Picatout/bp-chipcon/schip-mode.png

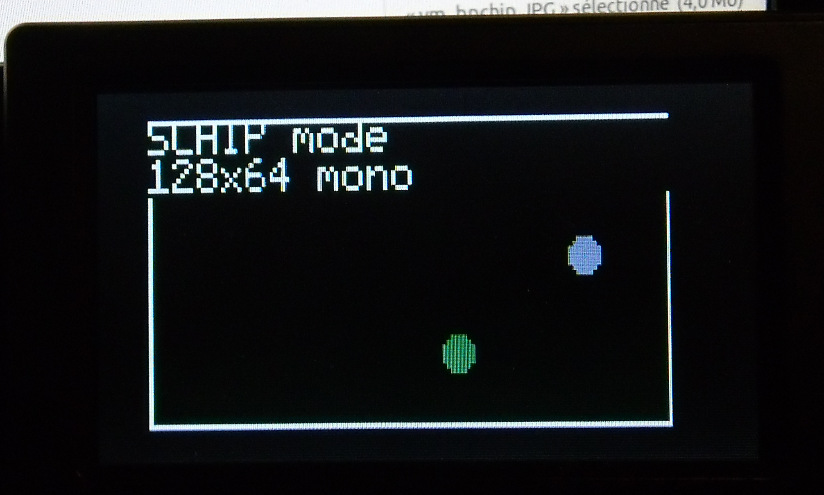
schip-mode.png
