Picatout/bp-chipcon/vm_bpchip.JPG

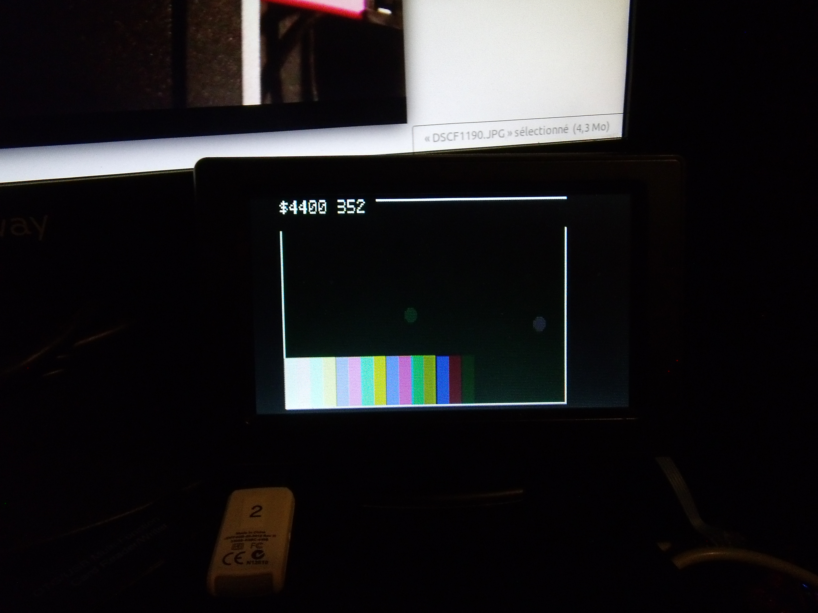
vm_bpchip.JPG
