Picatout/bp-chipcon/vmode-bp-chip.jpg

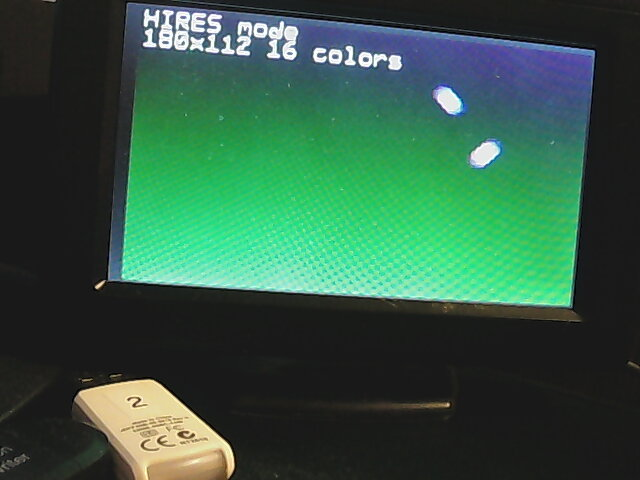
vmode-bp-chip.jpg
