Picatout/bp-chipcon/bp-chipcon-schematic.pdf

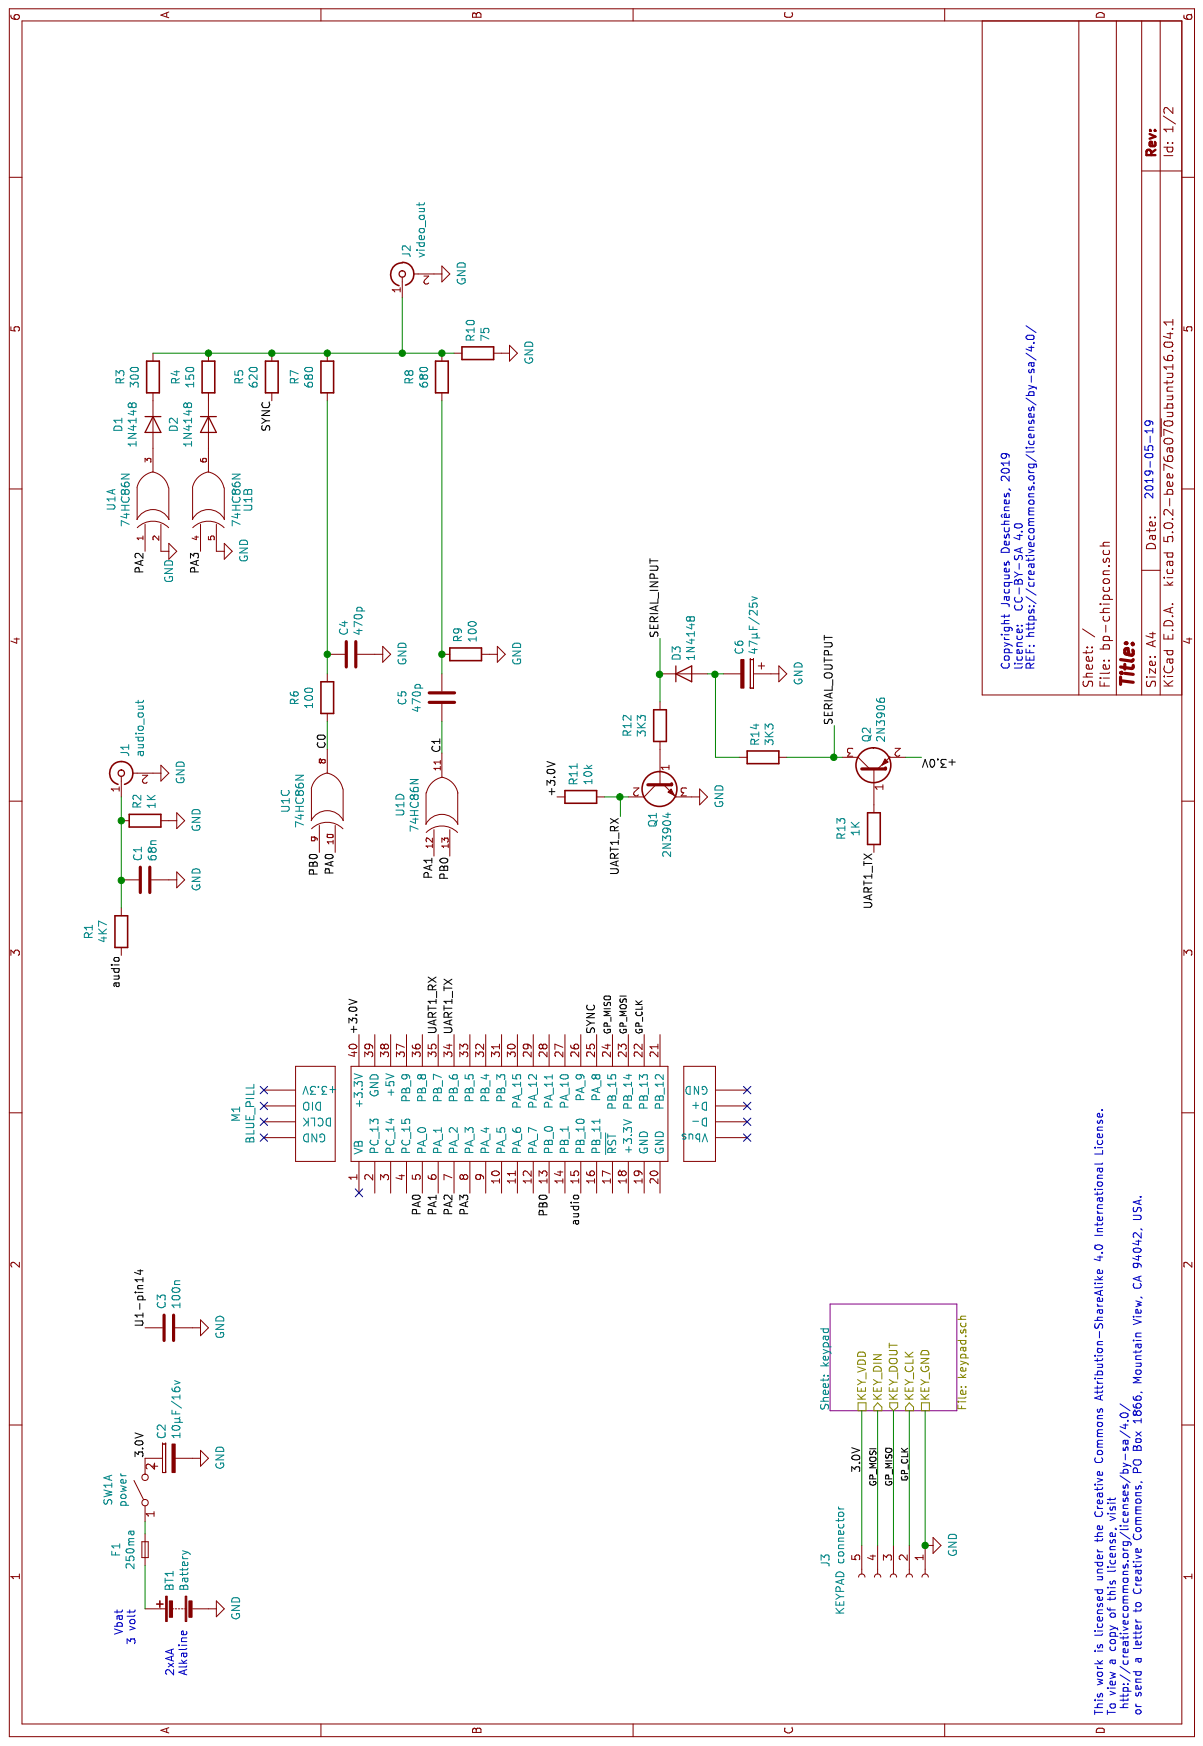
[picture p18: page 1]

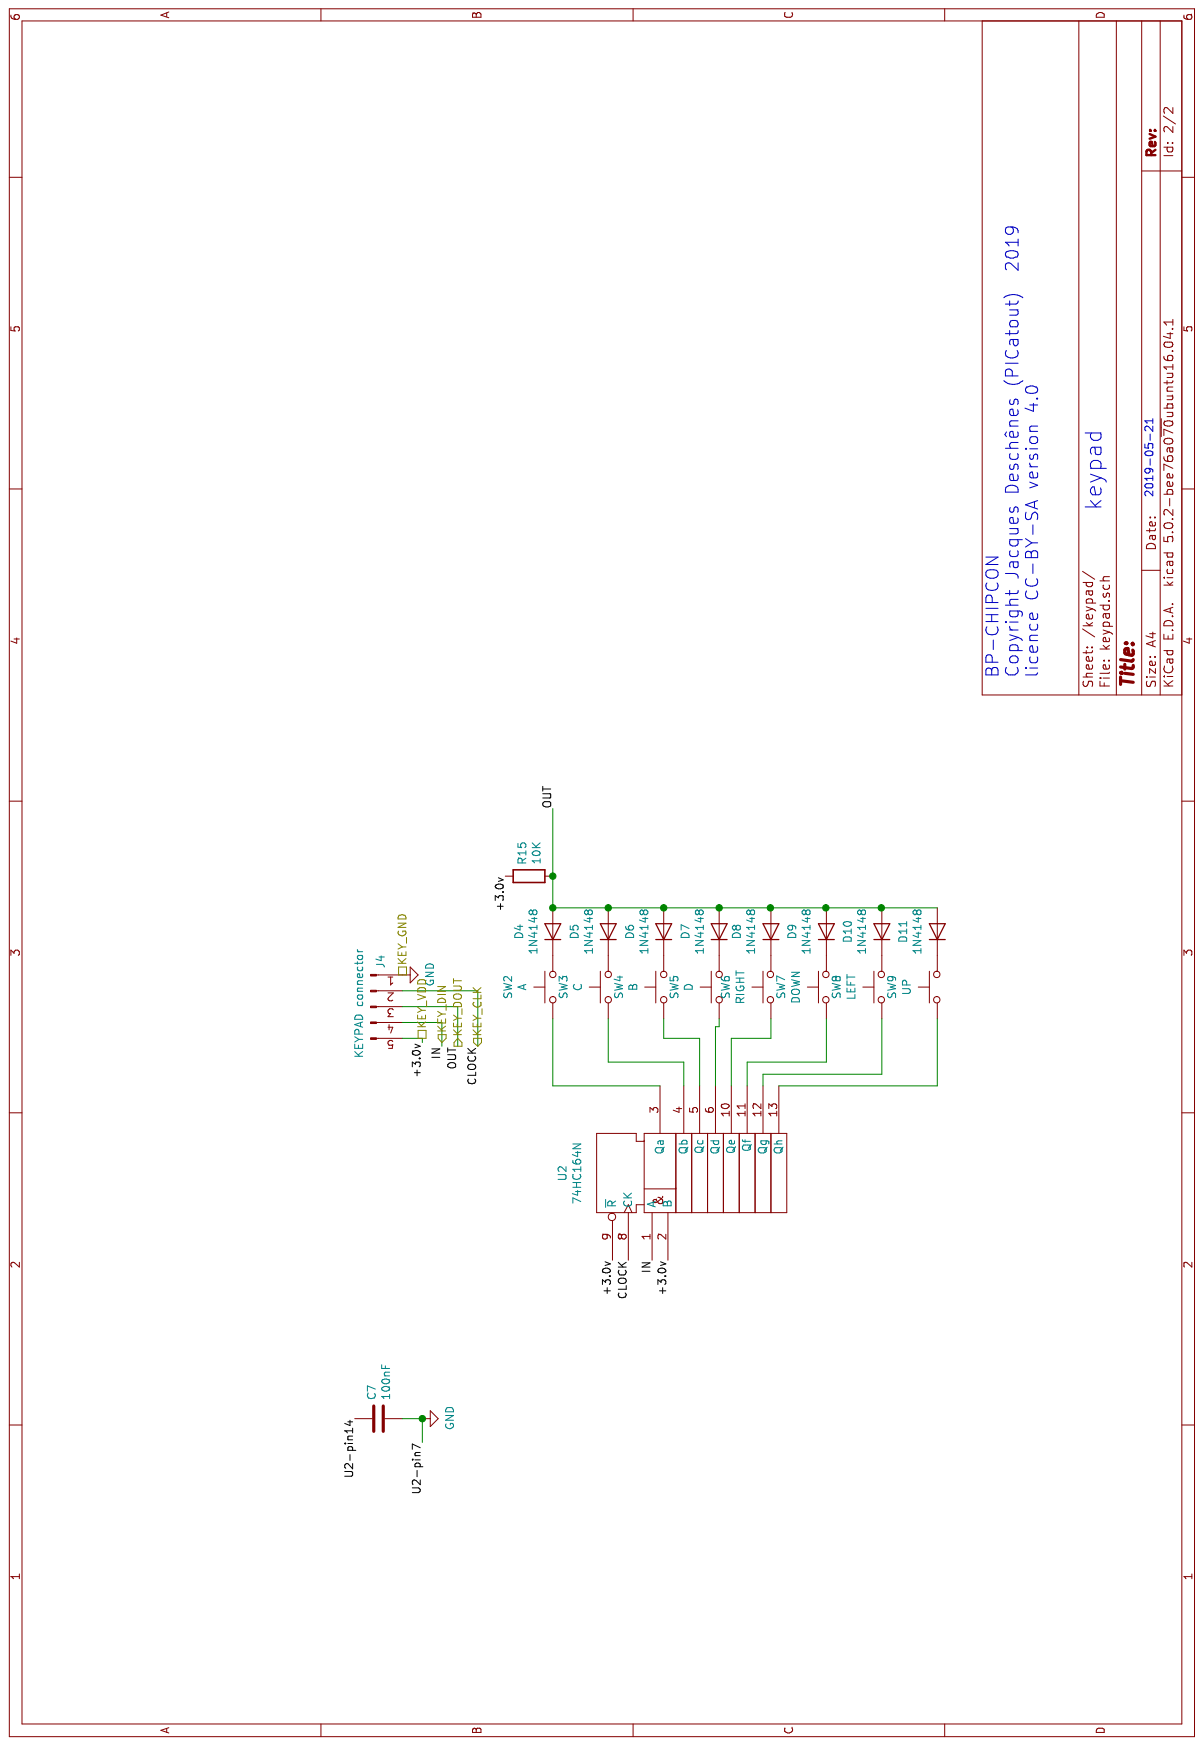
[picture p19: page 2]
