Picatout/bp-chipcon/KiCAD/bp-chipcon/bp-chipcon.kicad_pcb

## KiCad design Reflectance_Sensor/Reflectance_Sensor.sch

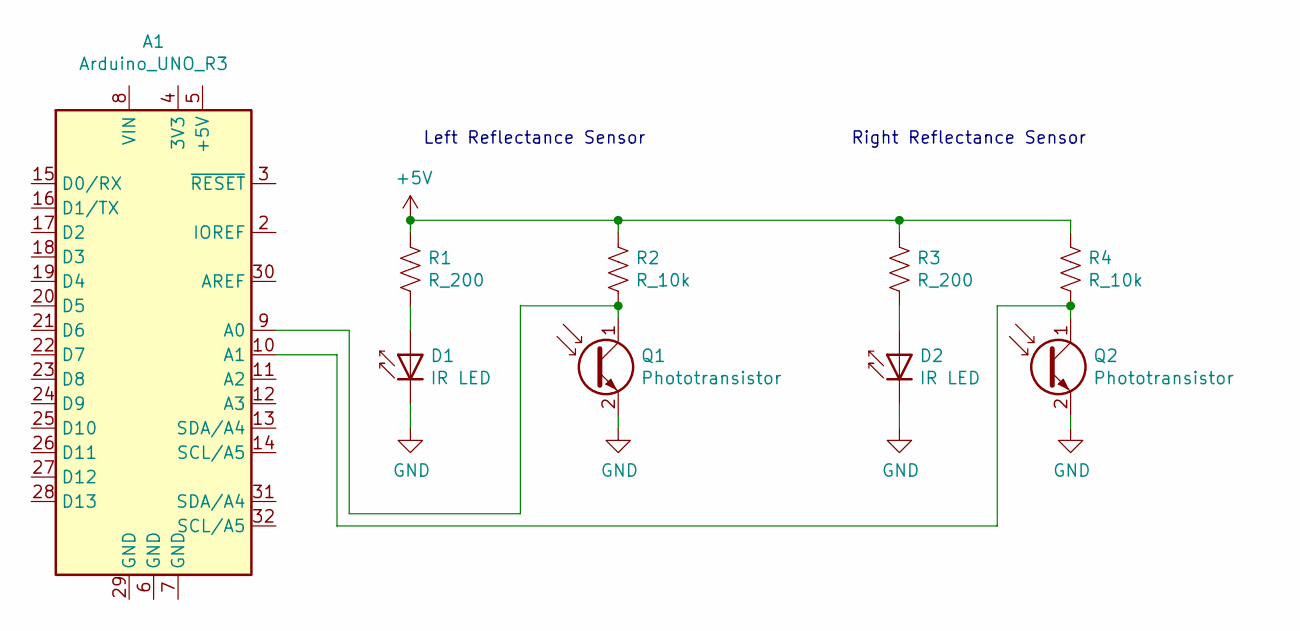
[picture p20: schematic Reflectance_Sensor.sch]

Parts:
A1: Arduino_UNO_R3
D1, D2: IR LED; LED_D3.0mm_IRBlack
Q1, Q2: Phototransistor
R1, R3: R_200
R2, R4: R_10k

Connections:
+5V: R1.1, R2.1, R3.1, R4.1
GND: D1.1 (K), D2.1 (K), Q1.2 (E), Q2.2 (E)
unnamed: A1.9 (A0), Q1.1 (C), R2.2
unnamed: A1.10 (A1), Q2.1 (C), R4.2
unnamed: D1.2 (A), R1.2
unnamed: D2.2 (A), R3.2

Notes on the sheet:
Left Reflectance Sensor
Right Reflectance Sensor
