Picatout/bp-chipcon/graphics.c

/*
* Copyright Jacques Deschênes 2018, 2019 
* This file is part of BP_CHIPCON.
*
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
*     You should have received a copy of the GNU General Public License
*     along with BP_CHIPCON.  If not, see <http://www.gnu.org/licenses/>.
*/

/*
 * Description: SUPER CHIPCON game console on BLUE PILL.
 * 
 * Auteur: PICATOUT
 * Date: 2019-05-01
 * Copyright Jacques Deschênes, 2019
 * Licence: GPLv3
 * revisions:
 * 
 */
/*
    graphics functions
*/


#include "include/blue_pill.h"
#include "tvout.h"
#include "include/ascii.h"
#include "graphics.h"
#include "text.h"

bits_per_pixel_t sprite_bpp=FOUR_BPP;
// palette 4 couleurs pour les sprites 1 ou 2 bits/pixel
static uint8_t palette[4]={0,15,3,5};

const uint8_t DEFAULT_PALETTE[4]={0,15,3,5};

void set_palette(const uint8_t new[4]){
    palette[0]=new[0];
    palette[1]=new[1];
    palette[2]=new[2];
    palette[3]=new[3];
}

int gfx_blit(int x, int y, uint8_t color, blit_op_t op){
	register int idx;
    int collision;
    register uint8_t byte,mask;
    vmode_params_t *vparams=get_video_params();
	if ((x<0) || (x>=vparams->hres) || (y<0) || (y>=vparams->vres)) return 0;
    idx=y*vparams->bpr+x/2;
    color&=0xf;
    mask=0xf0;
    if (!(x&1)){
         color<<=4;
         mask=0x0f;
    }
    byte=video_buffer[idx];
    switch (op){
    case BIT_OR:
        byte|=color;
        break;
    case BIT_AND:
        byte&=color;
        break;
    case BIT_XOR:
        byte^=color;
        break;
    case BIT_INVERT:
        byte^=~mask;
        break;
    case BIT_SET:
        byte &=mask;
        byte|=color;
        break;
    }//switch (op)
    video_buffer[idx]=byte;
    return !((byte&~mask)^color==0);
}

/*
void gfx_plot (int x,int y,uint8_t color){
	register int idx;
    register uint8_t byte;
    vmode_params_t *vparams=get_video_params();
	if ((x<0) || (x>=vparams->hres) || (y<0) || (y>=vparams->vres) ) return;
    idx=y*vparams->bpr+x/2;
    color&=0xf;
    byte=video_buffer[idx];
    if (x&1){
        byte&=0xf0;
        byte|=color;
    }else{
        byte&=0xf;
        byte|=color<<4;
    }
    video_buffer[idx]=byte;
}
*/

void gfx_cls(){
	int x;
    vmode_params_t *vparams=get_video_params();
	for (x=0;x<VIDEO_BUFFER_SIZE;x++) video_buffer[x]=0;
    set_cursor(0,0);
}

static uint8_t* move_up(uint8_t* src, uint8_t* dest, int size){
    while (size--) *--dest=*--src;
    return dest;
}

static uint8_t* move_down(uint8_t* src, uint8_t* dest, int size){
    while (size--) *dest++=*src++;
    return dest;
}


void gfx_scroll_up(uint8_t n){
    uint8_t *src,*dest;
    int size;
    vmode_params_t *vparams=get_video_params();
    src=&video_buffer[n*vparams->bpr];
    dest=video_buffer;
    size = (vparams->vres-n)*vparams->bpr;
    dest=move_down(src,dest,size);
    size=vparams->bpr*n;
    while (size--) *dest++=0;
}

void gfx_scroll_down(uint8_t n){
    uint8_t *src,*dest;
    int size;
    vmode_params_t *vparams=get_video_params();
    src=&video_buffer[(vparams->vres-n)*vparams->bpr];
    dest=&video_buffer[vparams->vres*vparams->bpr];
    size = (vparams->vres-n)*vparams->bpr;
    dest=move_up(src,dest,size);
    size=vparams->bpr*n;
    while (size--) *--dest=0;
}

// pixels shift is 2*n
void gfx_scroll_left(uint8_t n){
    int y,size;
    uint8_t *src, *dest;
    vmode_params_t *vparams=get_video_params();
    for (y=0;y<vparams->vres;y++){
        dest=&video_buffer[y*vparams->bpr];
        src=dest+n;
        size=vparams->hres/2-n;
        dest=move_down(src,dest,size);
        size=n;
        while (size--) *dest++=0;
    }
}

// pixels shift is 2*n
void gfx_scroll_right(uint8_t n){
    int y,size;
    uint8_t *src, *dest;
    vmode_params_t *vparams=get_video_params();
    for (y=0;y<vparams->vres;y++){
        dest=&video_buffer[y*vparams->bpr]+vparams->bpr;
        src=dest-n;
        size=vparams->hres/2-n;
        dest=move_up(src,dest,size);
        size=n;
        while (size--) *--dest=0;
    }
}


uint8_t gfx_get_pixel(int x, int y){
    register uint8_t byte;
    vmode_params_t *vparams=get_video_params();
    if (x<0 || x>=vparams->hres || y<0 || y>=vparams->vres) return 255;
    byte=video_buffer[y*vparams->bpr+(x>>1)];
    if (!(x&1)) byte>>=4;
    return byte&0xf;
}

static const uint8_t bit_mask[3]={0x80,0xc0,0xf0};
static const uint8_t bit_shift[3]={7,6,4};
static const uint8_t pixels_per_byte[3]={8,4,2};
// put sprite on screen using BIT_XOR
int gfx_sprite(int x, int y, uint8_t width, uint8_t height, const uint8_t *sprite){
    register uint8_t color,bmp_byte,mask,shift,ppb;
    register int x0,y0;
    int collision=0;
    
    shift=bit_shift[sprite_bpp];
    bmp_byte=*sprite++;
    mask=bit_mask[sprite_bpp];
    ppb=pixels_per_byte[sprite_bpp];
    for (y0=y;y0<(y+height);y0++){ 
        for(x0=x;x0<(x+width);x0++){
            if (sprite_bpp<FOUR_BPP){
                color=palette[bmp_byte>>shift];
            }else{
                color=bmp_byte>>shift;
            }
            collision|=gfx_blit(x0,y0,color,BIT_XOR);
            bmp_byte<<=(8-shift);
            ppb--;
            if (!ppb){
                bmp_byte=*sprite++;
                ppb=pixels_per_byte[sprite_bpp];
            }
        }//for(x)
    }//for(y0)
    return collision;
}
