Picatout/bp-chipcon/gen_fn.c

/*
* Copyright Jacques Deschênes 2018, 2019 
* This file is part of BPOS.
*
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
*     You should have received a copy of the GNU General Public License
*     along with BPOS.  If not, see <http://www.gnu.org/licenses/>.
*/

/*
 * DESCRIPTION: fonctions d'usage générale.
 * Auteur: PICATOUT
 * Date: 2018-12-31
 * Copyright Jacques Deschênes, 2018, 2019
 * Licence: GPLv3
 * revisions:
 * 
 */

#include "include/ascii.h"

int strcmp(const char *s1, const char *s2){
	int result=0;
	while (*s1 && *s2){
		if (*s1<*s2){
			result=-1;
			break;
		}else if (*s1>*s2){
			result=1;
			break;
		}
		s1++;
		s2++;
	}
	if (!result){
		if (!*s1 && *s2){
			result=-1;
		}else if (*s1 && !*s2) {
			result=1;
		}
	}
	return result;
}

// retourne vrai si c'est une lettre
int alpha(char c){
	return ((c>='a') && (c<='z') ) || ((c>='A') && (c<='Z'));
}

int digit(char c){
   return ((c>='0') && (c<='9'));
}

int hexdigit(char c){
	if (c>='a') c-=32;
	return (digit(c) || (c>='A' && c<='F'));
}

int atoi(const char *str){
	int n=0,sign=1,base=10;
    char c;
    
	while (*str && (*str==SPACE)) str++;
	if (*str=='-'){
		sign=-1;
		str++;
	}
	if (*str=='$' && hexdigit(*(str+1))){
		base=16;
		str++;
	}
	else if (*str=='0' && ((*(str+1)=='x')||(*(str+1)=='X'))){
		base=16;
		str+=2;
	}
	while ((c=*str) && base==10?digit(c):hexdigit(c)){
		if (c>='a'){c-=32;}
		c-='0';
		if (c>9){c-=7;}
		n=n*base+c;
		str++;
	}
	return sign*n;
}

// copie 'len' caractères de src vers dest
void move(const char *src , char *dest, unsigned int len){
	while (len){
		*dest++=*src++;
		len--;
	}
}

int strlen(const char* str){
	int ll=0;
	while (str[ll]){ll++;}
	return ll;
}

void fill(void *buffer, unsigned int size, char c){
	int i;
	for (i=0;i<size;i++)*(char*)buffer++=c;
}

//retourne vrai si caractère en minuscule
int is_lower(char c){
	return (c>='a') && (c<='z');
}

//retourne vrai si caractère en majuscule
int is_upper(char c){
	return (c>='A') && (c<='Z');
}

// conversion en majuscule in situ
void uppercase(char *buffer){
	while (*buffer){
		if (is_lower(*buffer)){*buffer-=32;}
		buffer++;
	}
}

// recherche la première occurance de 'c'
int scan(const char *buffer, int start, char c){
	while (buffer[start] && buffer[start]!=c) start++;
	return start;
}

// saute tous les caractères 'c' à partir de la position 'start'
// retourne la nouvelle position
int skip(const char *buffer, int start, char c){
	while (buffer[start] && buffer[start]==c) start++;
	return start;
}

// concatenation de la chaîne s2 à la fin de s1
char* strcat(char* s1, const char* s2){
	s1+=strlen(s1);
	while (*s2){
		*s1++=*s2++;
	}
	*s1=0;
	return s1;
}

char *itoa(int n,char *buffer,int base){
	char d,fmt[16];
	int i=14,sign=0;
	if ((base==10) && (n<0)){
		sign=1;
		n=-n;
	}
	fmt[15]=0;
	fmt[14]=' ';
	while (n){
		d=n%base+'0';
		if (d>'9') d+=7;
		n/=base;
		fmt[--i]=d;
	}
	if (i==14) fmt[--i]='0';
	if ((base==10) && sign) fmt[--i]='-';
	if (base==16) fmt[--i]='$';
	move((const char*)&fmt[i],buffer,16-i);
	return buffer;
}
