Picatout/bp-chipcon/(commit log)

2019-05-09 began to draw schematic
    [bp-chipcon.kicad_pcb, bp-chipcon.sch]
2019-05-10 working on schematic and color scheme
    [bp-chipcon.sch]
2019-05-10 work on tvout
    [bp-chipcon.sch]
2019-05-12 modification to schematic
    [bp-chipcon.sch]
2019-05-13 ajout de chipcon_vm
2019-05-16 Added video modes CHIP8, SCHIP, XOCHIP
    [bp-chipcon.sch]
2019-05-17 work on TV_OUT_handler to reduce jitter
    [graphics.c, main.c, timer.h, tvout.c, tvout.h]
2019-05-20 added menu and modfications to buttons functions
    [bp-chipcon.sch]
2019-05-21 modified schematic, eliminated chroma output on PB1. PB0 drive both xor gates. Improved video output pixels size. Pixel width on odd x position were larger than those on even x position. Still trying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
    [bp-chipcon.sch]
2019-05-22 Modified schematic added keypad sheet
    [bp-chipcon.sch]
2019-05-23 Working on TV_OUT_handler gamepad interface added game_timer and sound_timer
    [bp-chipcon.sch]
2019-05-23 Added photos and modified readme.md
    [keypad.sch]
2019-05-31 Modification dans main.c, chipcon_vm.c ajouts de 4 jeux SCHIP
2019-05-31 réparé cvt-chip et ajouter des jeux
2019-06-02 modification to game list cdisplay. Added button A for HOME and button C for END now display GAME category i.e. SCHIP/BPCHIP
2019-06-04 modification to usart.c to add interrupt handler ont rx and rx_queue.
2019-06-05 Travail sur les outils bpcasm et cvt-chip débuté test machine virtuelle en mode BPCHIP
2019-06-06 Test vm en mode BPCHIP modification à usart.c modification au spport debug de la vm
2019-06-09 reset SCHIP_PDLY to 2 in tvout.c
    [tvout.c]
2019-06-12 Completed work on tvout.c completed serial port assembly on prototype
2019-06-14 corrected bug in serial port transmit circuit
    [bp-chipcon.sch]
2019-06-15 Modification to schematic, uart1 remapped to B6,B7
    [bp-chipcon.sch]
2019-06-16 Rework of tvout.c added video demo on youtube
    [bp-chipcon.sch]
